kevinr94/Filament_Dryer_FI-UNLZ/Practica Profesional Supervisada (PPS)/Notas proyecto.txt

- Estructura
	- Material madera
	- Bisagra para tapa superior

- Mecánica
	- Soporte para resistencia
	- Ventilador recirculador

- Electrónica
	- ESP32
	- Pantalla LCD (ver disponibilidad)
	- Fuente 220VCA a 5VC para alimentar ESP32
	- Modulo relé para controlar resistencia
	- Conversor lógico 5v-3.3v para convertir salidas de ESP32 al rele
	- Sensor DHT22 humedad y temperatura
