kevinr94/Filament_Dryer_FI-UNLZ/Contenido multimedia/20250331_102652.jpg

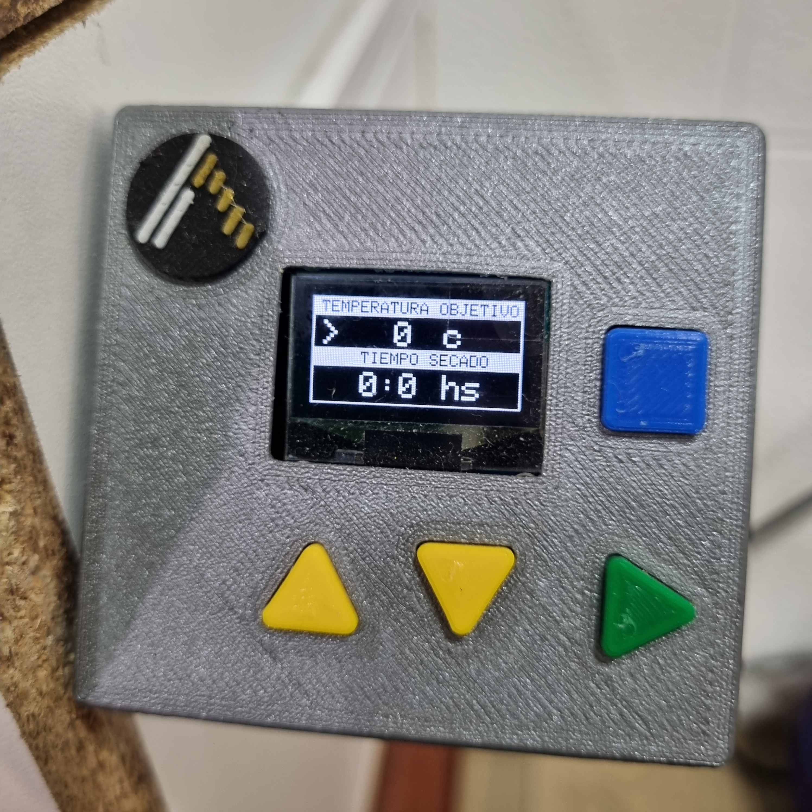
Contenido multimedia/20250331_102652.jpg
