kevinr94/Filament_Dryer_FI-UNLZ/Planos/Plano.pdf

400 | DISPLAY DISPLAY (1:3) | DISPLAY LAT DISPLAY LAT (1:3)

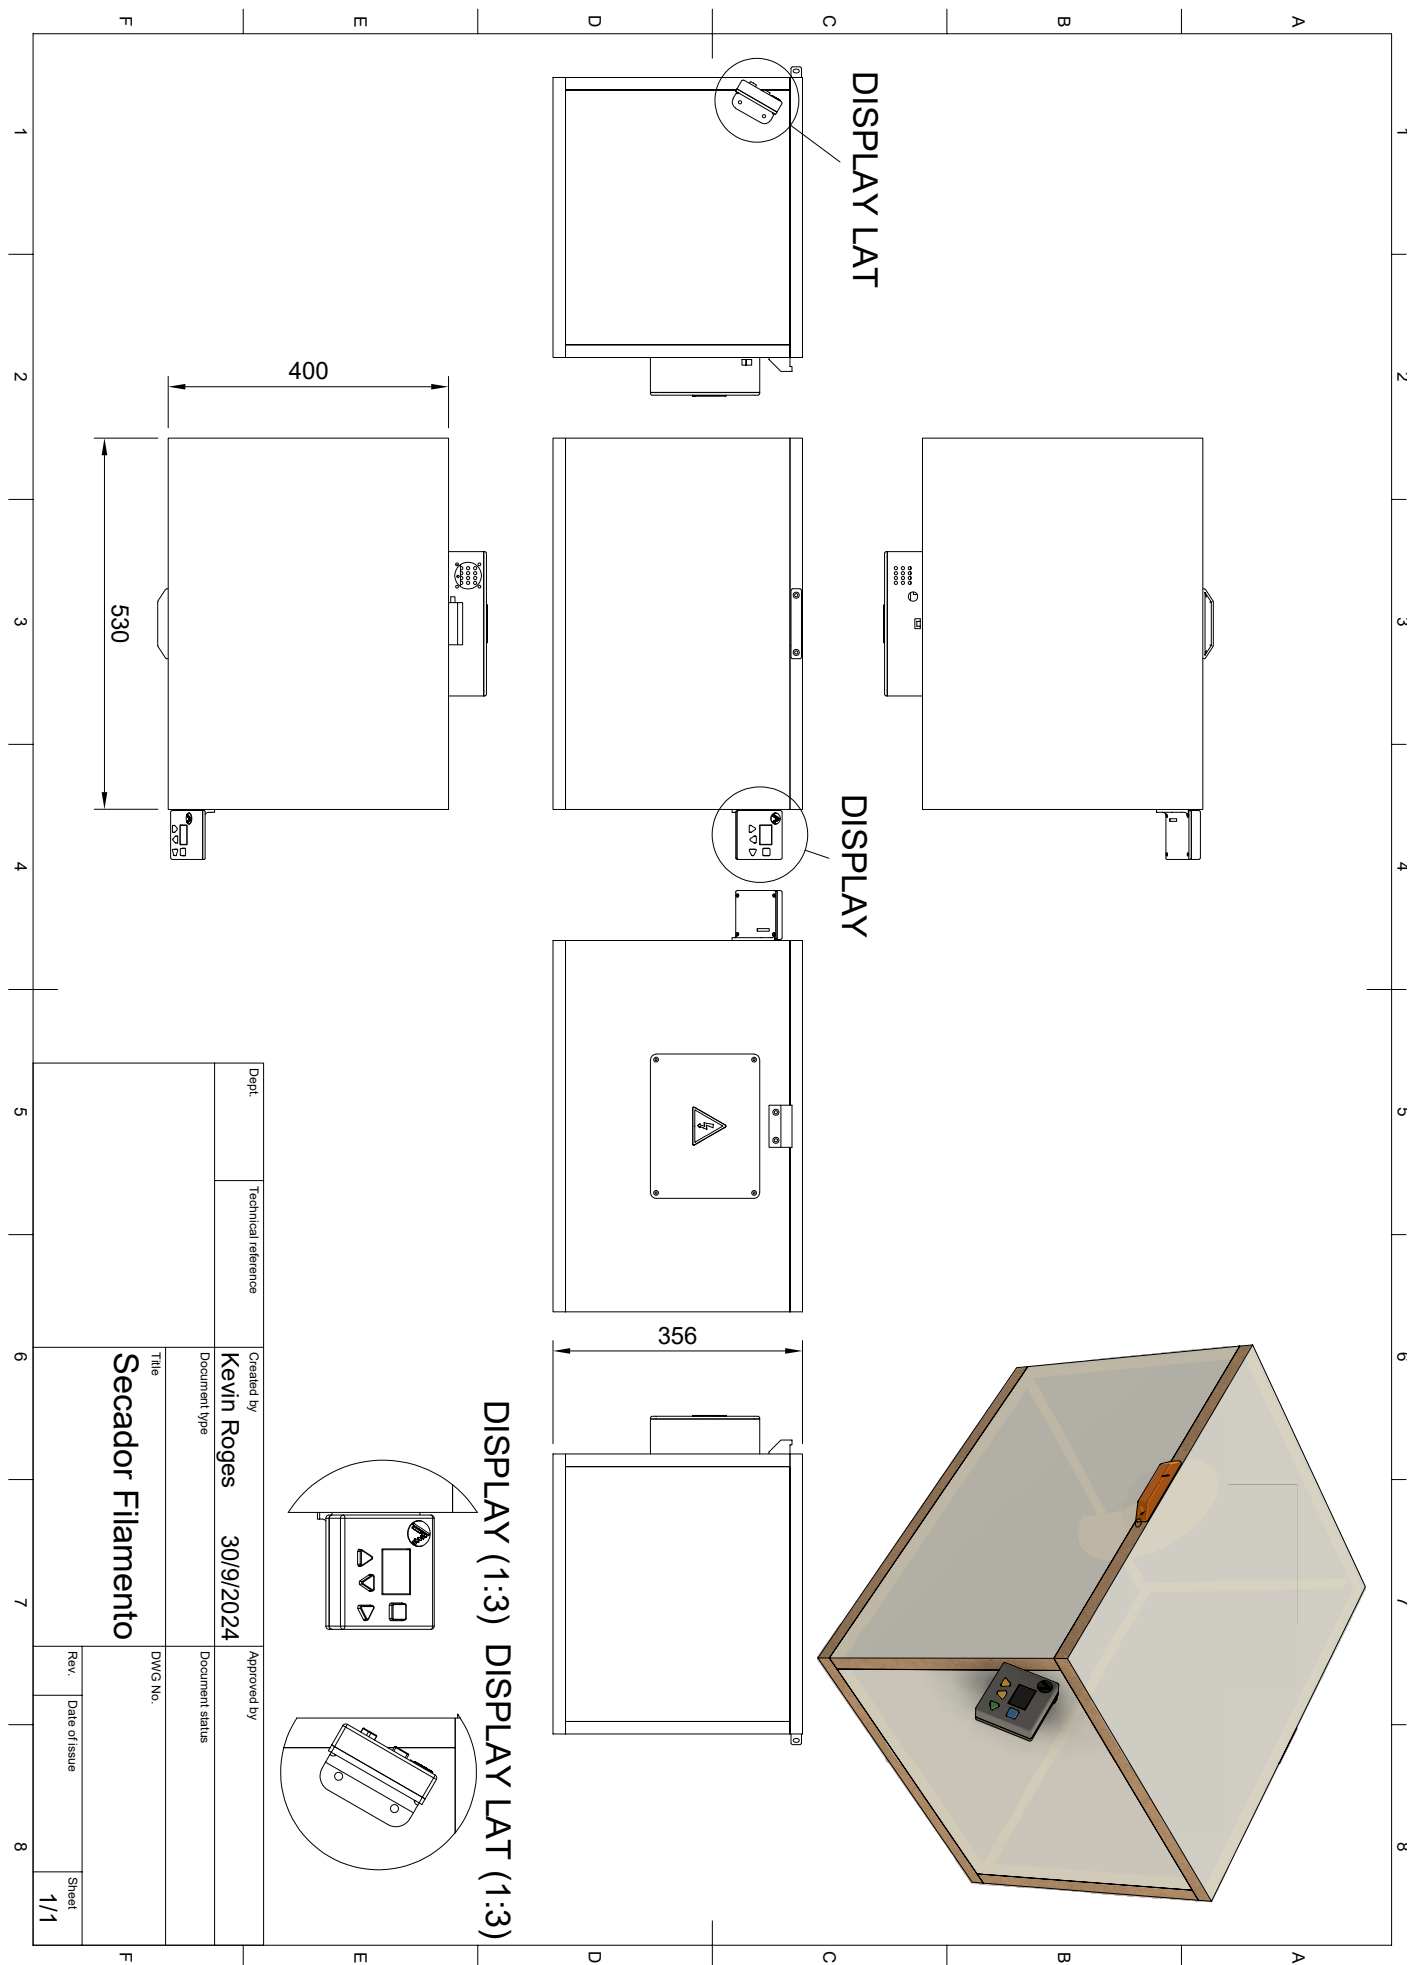
[picture p25: page 1]

1 A 2 3 4 5 6 7 8 1 2 3 4 5 6 7 8 FEDCB FEDCBA Dept. Technical reference Created by Approved by Title DWG No. Document type Document status Rev. Date of issue Sheet 30/9/2024 1/1 Secador Filamento Kevin Roges 530
